chcbaram/nu40dk/hardware/NU40-DK-V2-Basic.pdf

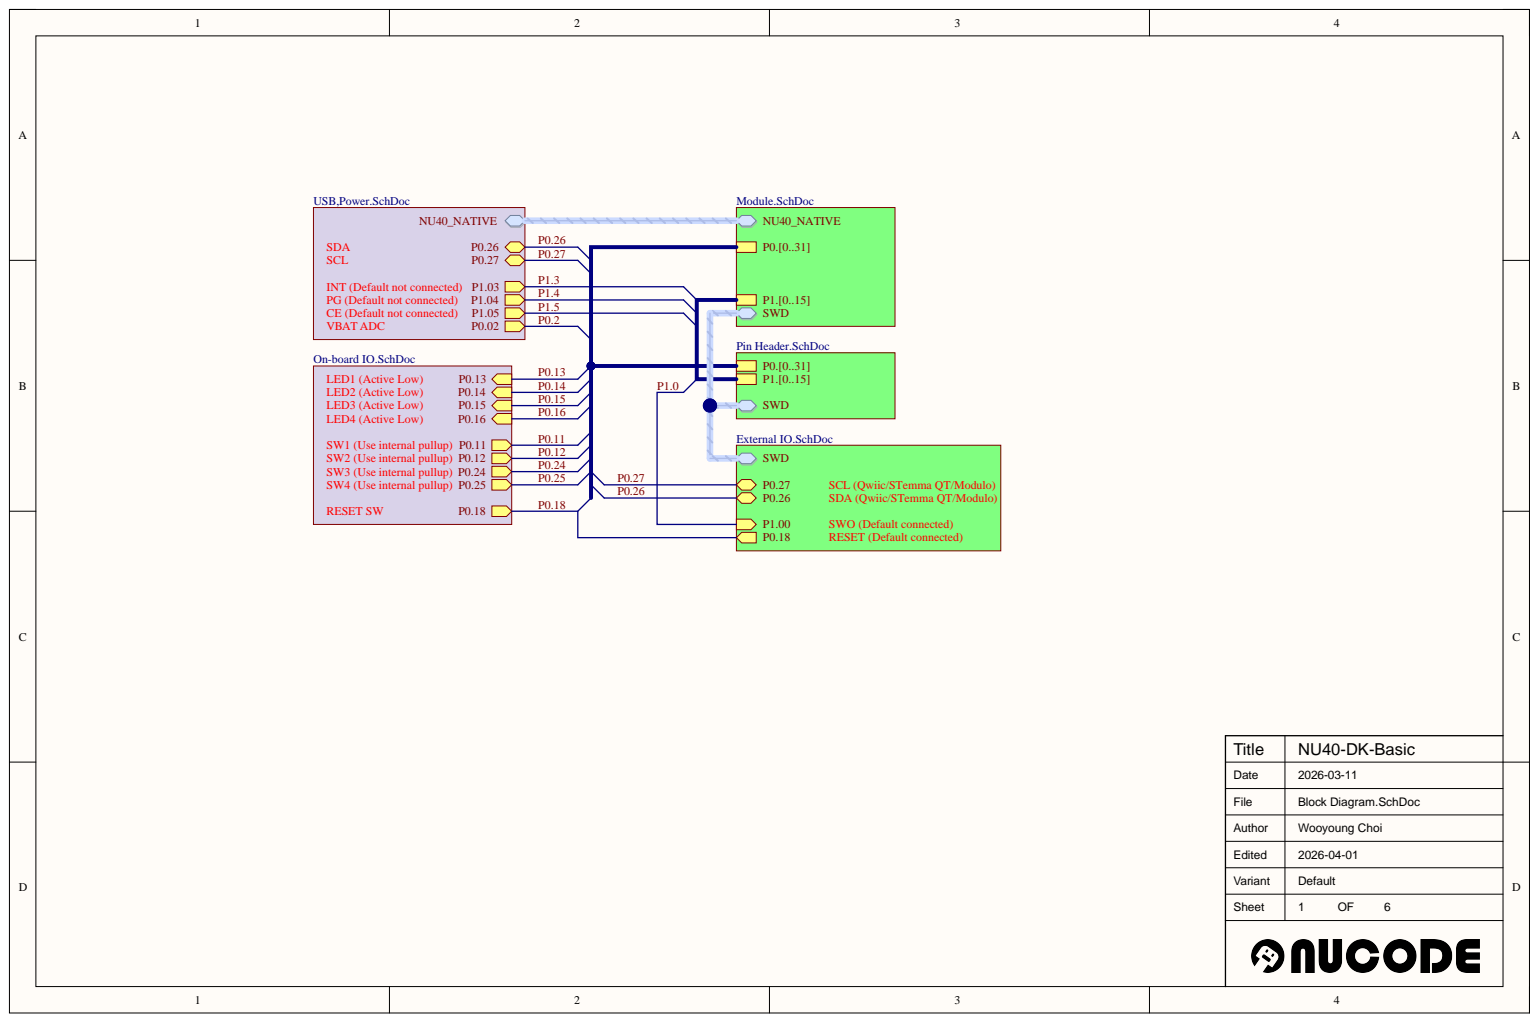
[picture p1: page 1]

INT (Default not connected)
PG (Default not connected)
CE (Default not connected)
P0.2 VBAT ADC

On-board IO.SchDoc
LED1 (Active Low)
LED2 (Active Low)
LED3 (Active Low)
LED4 (Active Low)

SCL (Qwiic/STemma QT/Modulo)
SDA (Qwiic/STemma QT/Modulo)

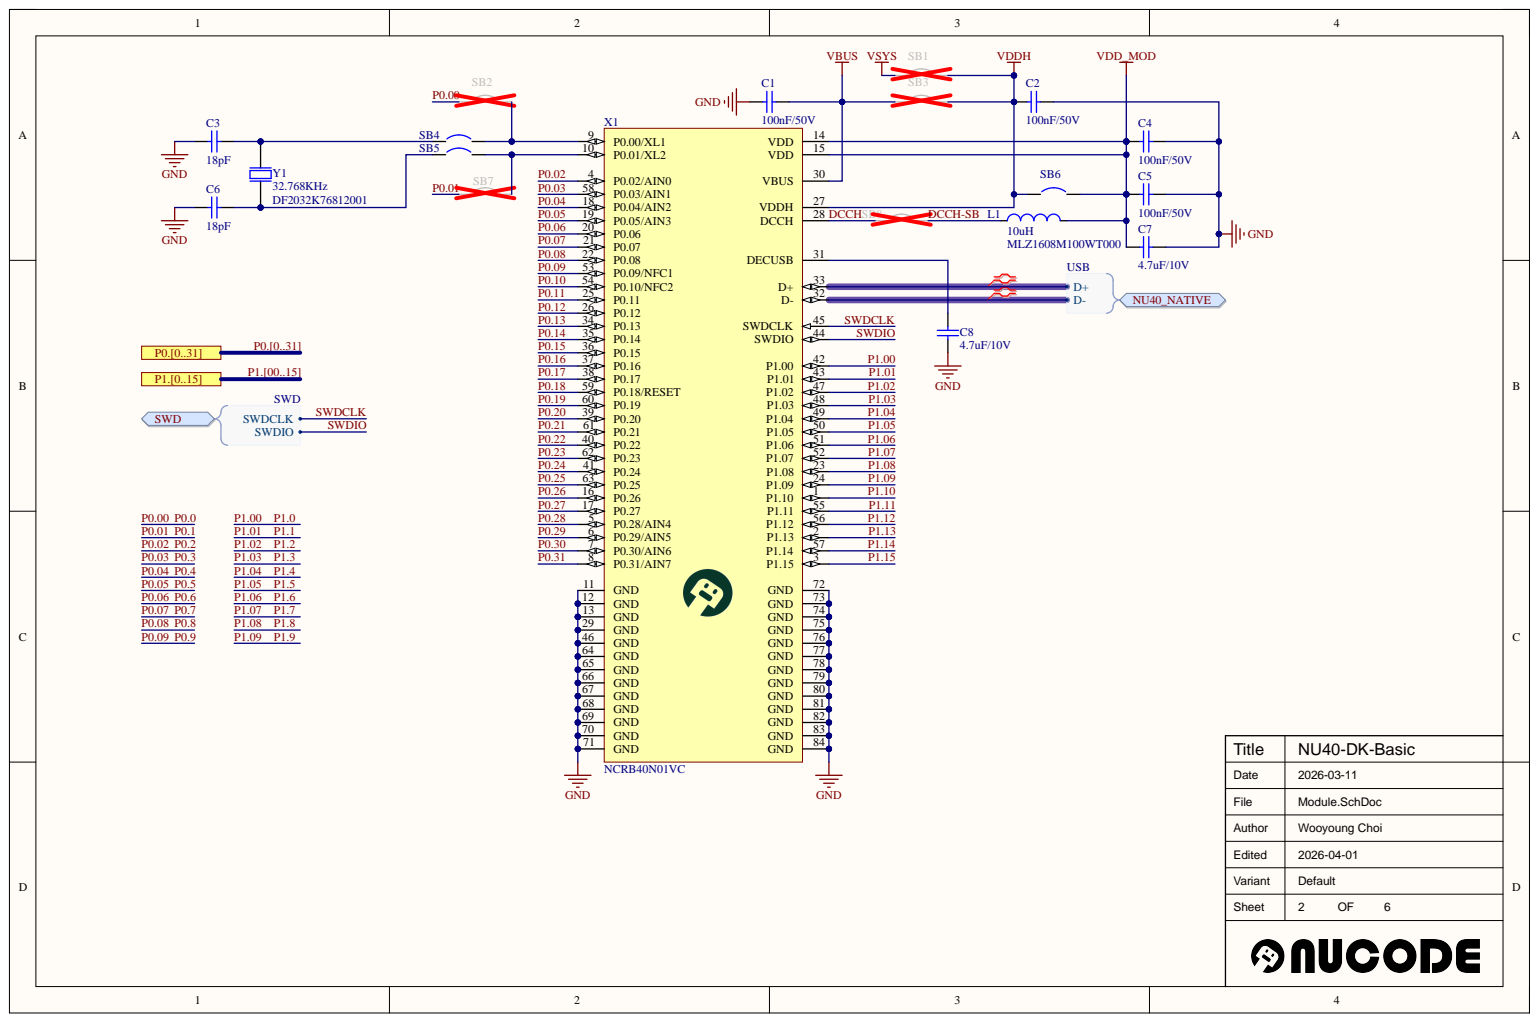
[picture p2: page 2]

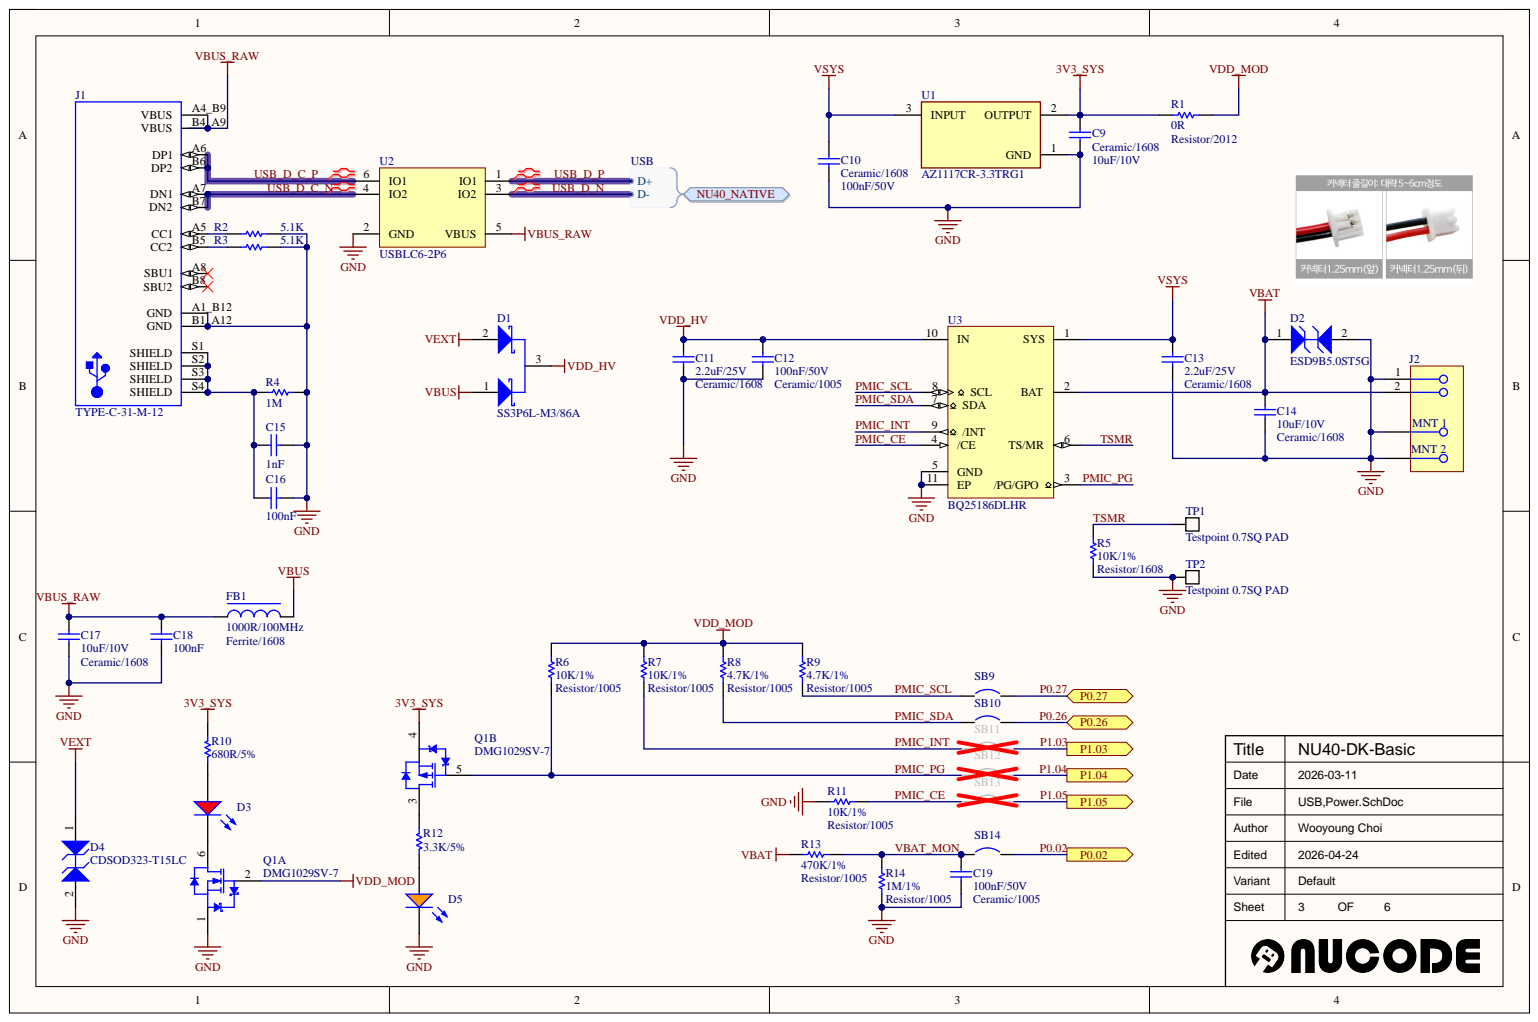
[picture p3: page 3]

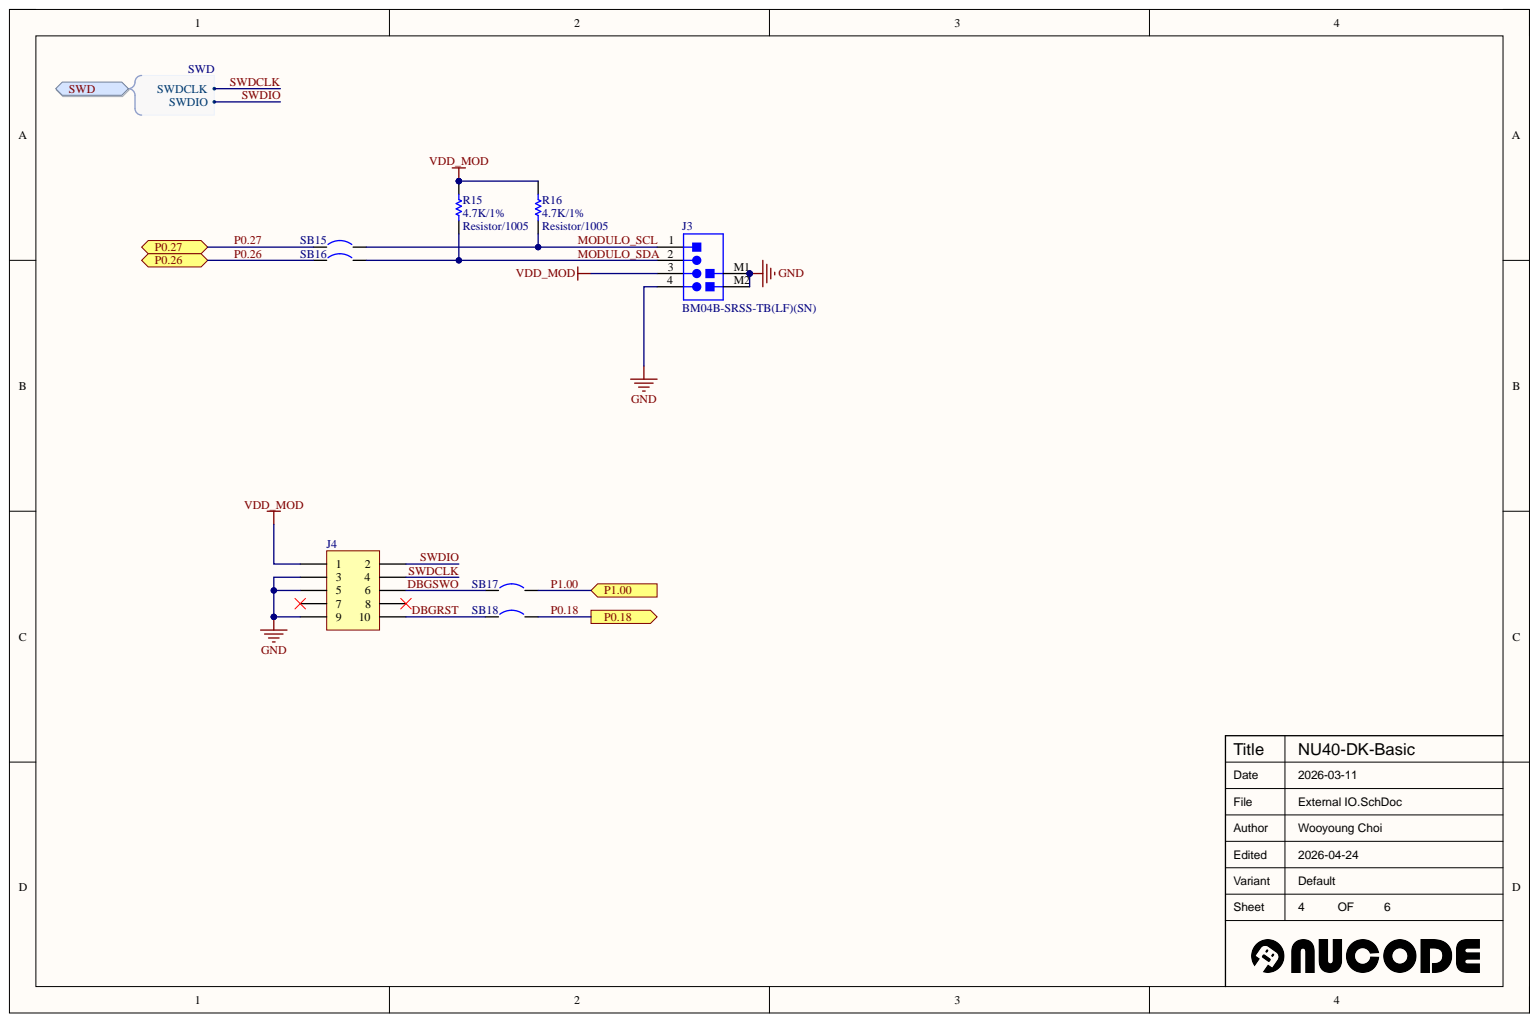
[picture p4: page 4]

BM04B-SRSS-TB(LF)(SN)

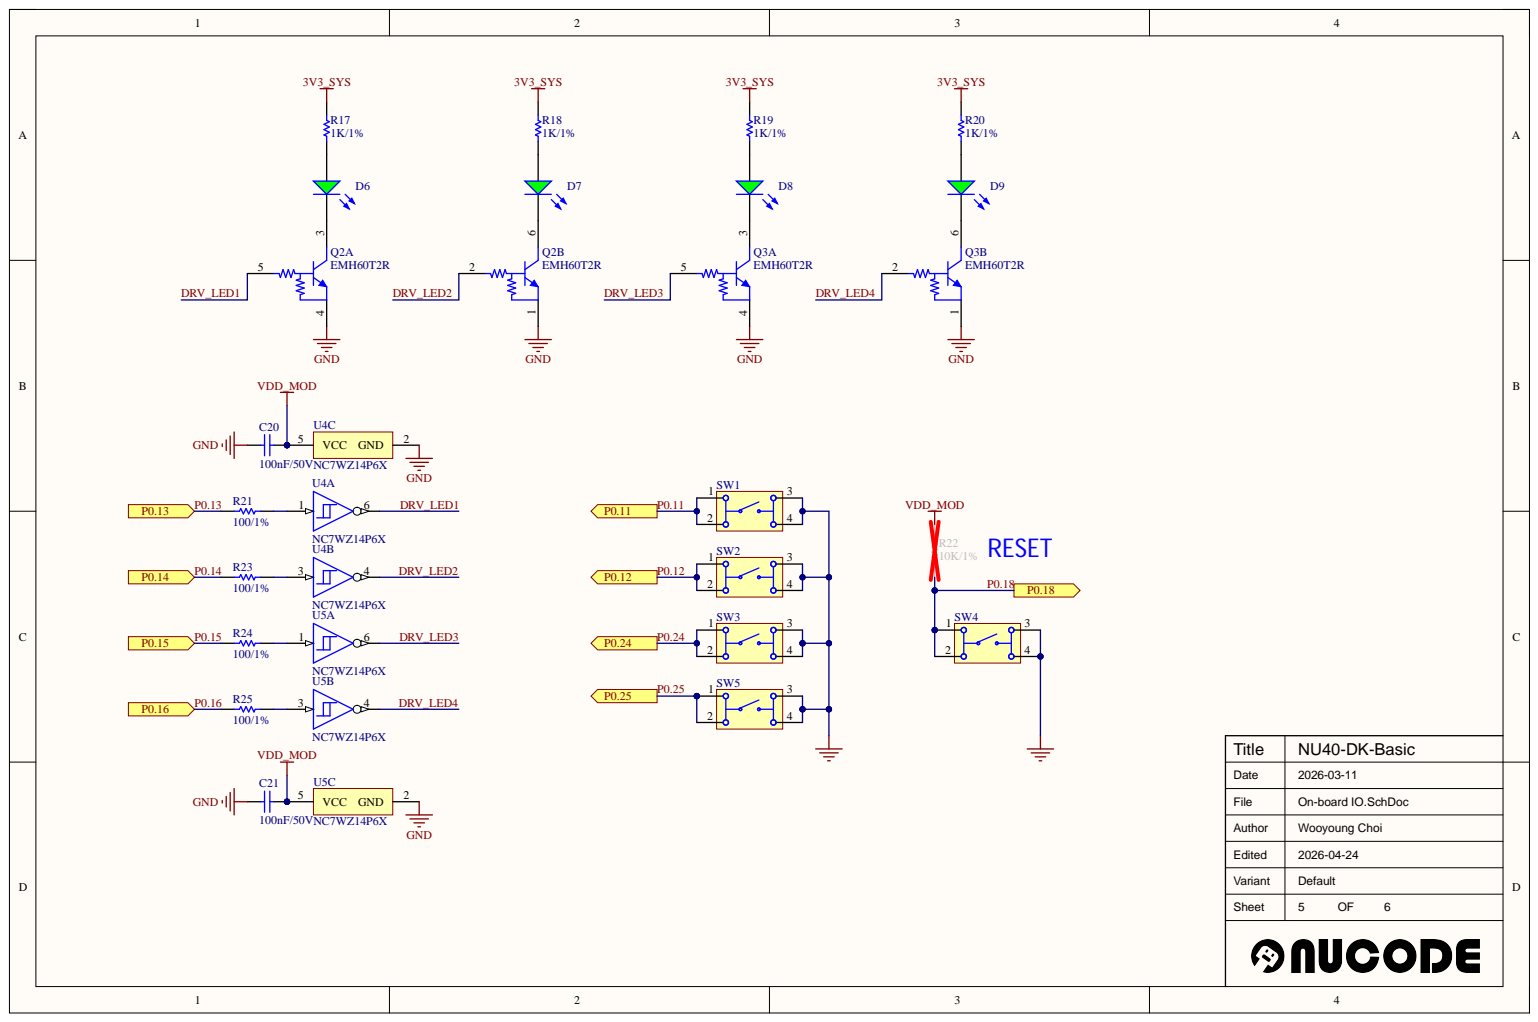
[picture p5: page 5]

On-board IO.SchDoc

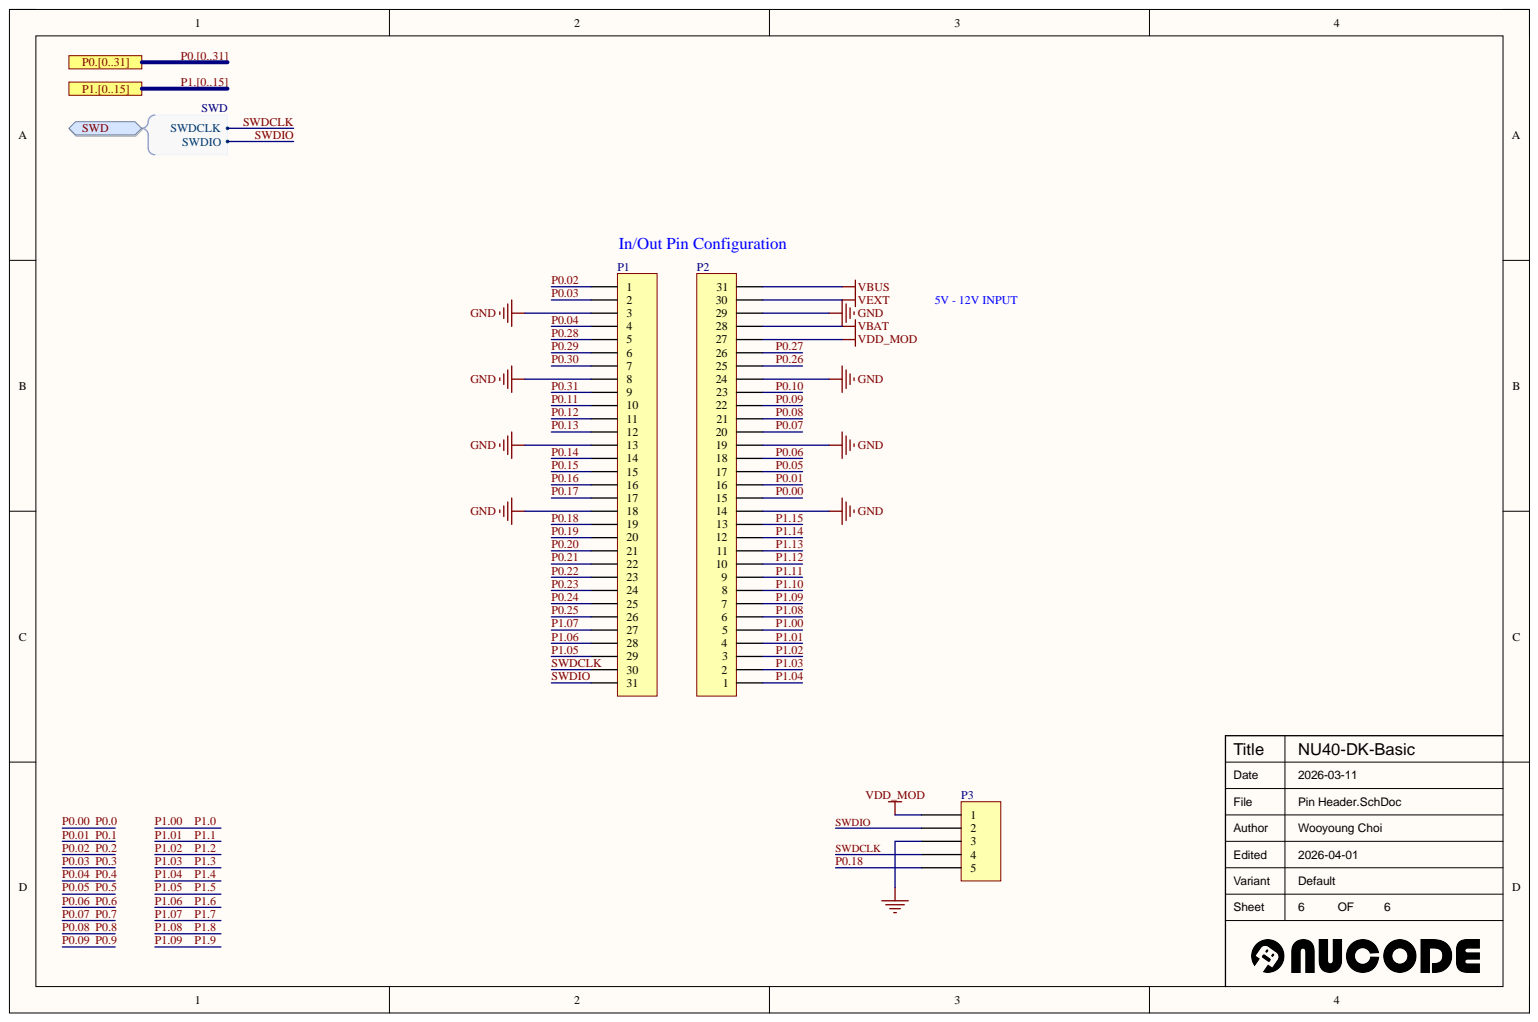
[picture p6: page 6]

In/Out Pin Configuration

GND GND
