chcbaram/nu40dk/hardware/NU40DK_Schematic.pdf

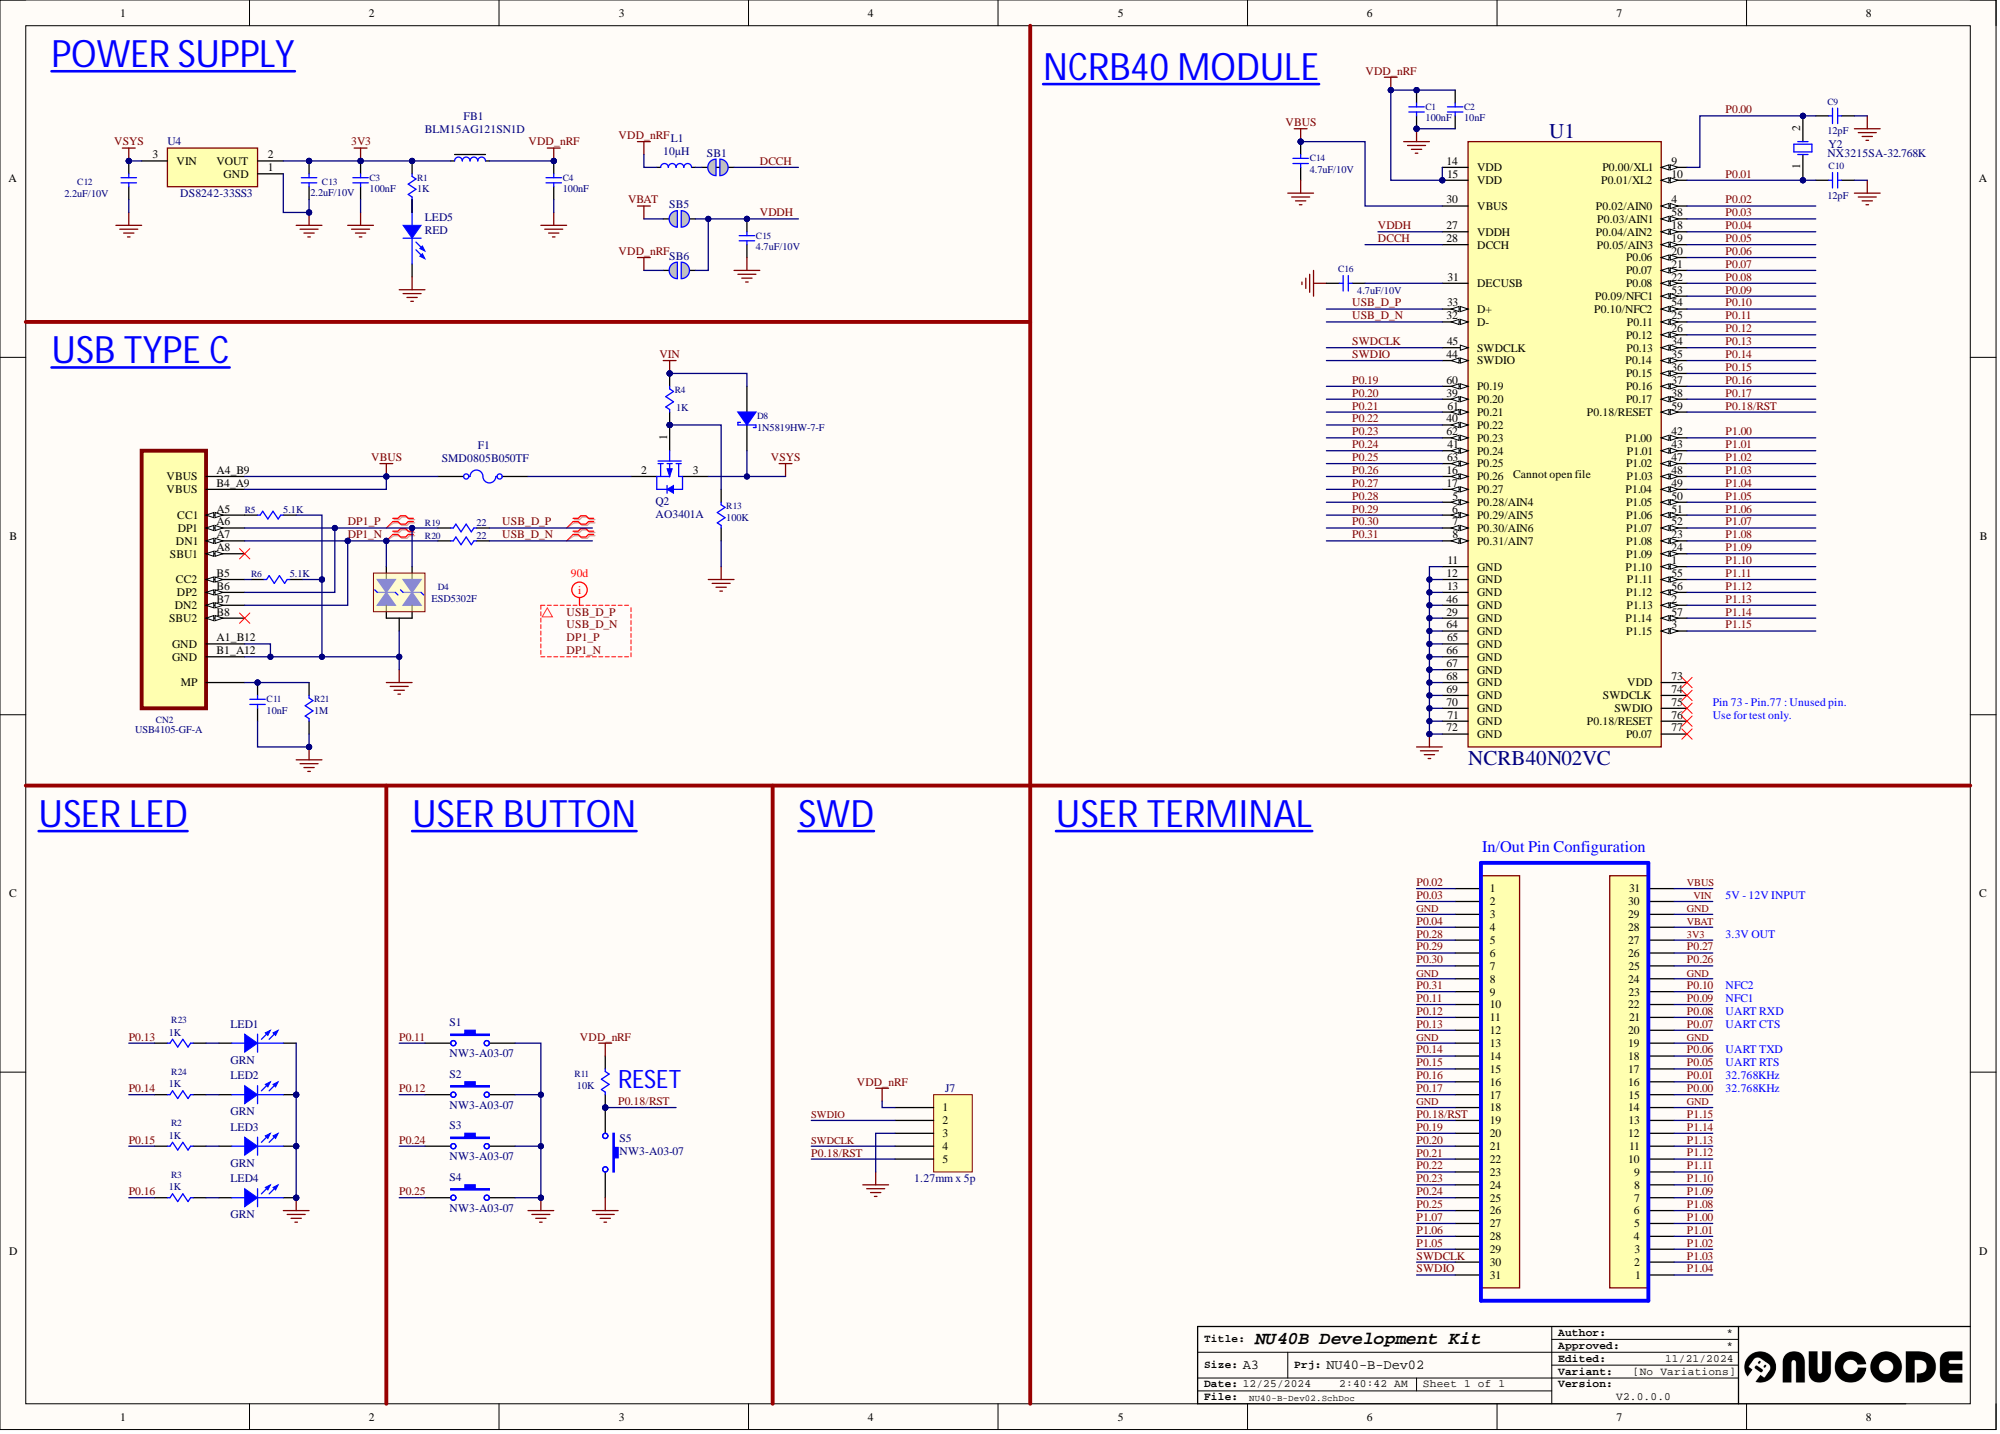
[picture p7: page 1]

Pin 73 - Pin.77 : Unused pin.
Use for test only.

In/Out Pin Configuration

Size: A3 | Prj: NU40-B-Dev02

Date: 12/25/2024 2:40:42 AM
