chcbaram/nu40dk/(commit log)

2025-01-26 초기 프로젝트 추가
2025-01-27 LED 추가
2025-01-28 LED(DT) 추가
2025-01-28 delay 함수 수정
2025-01-28 코드 정리
2026-07-25 NCS v3.3.0 빌드 오류 수정
    - board.yml에 full_name 추가 (v3.3.0 스키마 필수)
    - Kconfig.defconfig에서 삭제된 BT_CTLR 심볼 제거
2026-07-25 회로도 V2 추가 및 README 작성
2026-07-25 LED 4채널 디바이스 트리 방식 적용
    회로도 V2 기준 LED1~4(P0.13~P0.16, Active Low) 추가.
    led.c 에서 HW_TYPE_NRF 직접 제어 경로 제거하고 gpio_dt_spec 만 사용.
    ap.c 에 LED 전체 시험 패턴 추가.
2026-07-25 리셋/DFU 진입 드라이버 추가
    resetToBoot() 이 GPREGRET 에 Adafruit 부트로더의 OTA DFU 매직(0xA8)을 쓰고 리부트한다.
    리셋 사유(RESETREAS) 기록과 부트 모드 저장(GPREGRET[1]) 포함.
    [reset.c]
2026-07-25 VS Code 빌드/플래시/디버깅 환경 구성
    - nRF Connect Actions 를 pyOCD 태스크와 cortex-debug 설정에 바인딩
    - 셸 PATH 오염을 피하려고 nrf-connect-process 타입 사용
    - 디버깅용 Kconfig(DEBUG_OPTIMIZATIONS, DEBUG_THREAD_INFO) 추가
    - 파티션 매니저 비활성화 (파티션은 디바이스 트리로 관리)
    - tools/find_toolchain.py 로 PC 별 툴체인 경로 조회 및 launch.json 갱신
    - 전역 gitignore 의 settings.json 규칙 예외 처리
2026-07-25 CLI 추가 (UART0)
    uart0 를 P0.06(TX)/P0.08(RX), 115200 으로 열고 CLI 를 연결한다.
    콘솔 서브시스템 대신 Zephyr UART 드라이버 API 를 직접 사용하며 RX 는 인터럽트로 qbuffer 에 쌓는다.
    led / uart / reset 명령 등록. reset boot 로 부트로더 DFU 진입.
    [reset.c, uart.c]
2026-07-25 CLI 채널을 USB CDC 로 변경
    - 하드웨어 UART 제거, 네이티브 USB CDC 로 전환 (보드에 UART 커넥터가 없음)
    - CDC 를 cdc.c 로 분리하고 uart.c 는 채널 위임만 담당
    - RX 콜백에서 uart_irq_update() 를 매 루프 호출하도록 수정 (무한 루프로 멈추던 문제)
    - 호스트가 포트를 열었을 때만 CLI 를 실행하고 아니면 100ms 주기로 대기
    - Kconfig APP_USE_CLI 로 CLI 전체를 빌드에서 제외 가능 (low_power.conf)
    [cdc.c, uart.c]
2026-07-25 modules 구조 도입 및 소비전류 측정 옵션 추가
    - .module 링커 섹션 기반 모듈 등록 (module.c/h, ldscript.ld)
    - CLI 를 cli_mgr.c 모듈 스레드로 분리. cdcWaitRx() 로 수신 이벤트에 블록
    - LED 를 display 모듈 스레드로 분리. 명령 큐 + 다음 전환까지만 대기,
    깜빡임이 없으면 K_FOREVER 로 블록
    - logPrintf() 최소 구현 (모듈 초기화 로그)
    - Kconfig APP_USE_HEARTBEAT_LED / APP_POWER_TEST 추가
    - power_test.conf (부팅 3초 후 System OFF), dcdc.overlay (REG1 DC/DC)
    - reset off 명령 (System OFF)
    [cdc.c]
